bsom/machination/hardware.md

- [x] Intel NUC NUC5i5MYBE board
  * Intel® Core™ i5-5300U Processor
- [x] Front Panel Express aluminum panel
- [x] 2x 4GB DDR3L-1866 SO-DIMMs
  * https://amzn.to/31vLyne
- [x] Samsung 860 EVO SATA m.2 SSD (pick your size and manufacturer, I like Samsung)
  * https://amzn.to/2We0dTb
- [x] SATA m.2 SSD Heatsink
  * https://amzn.to/35Uymvv
- [x] Waveshare 5.5in HDMI AMOLED 1920x1080 Monitor AMOLED Capacitive Touch Screen
  * https://amzn.to/31G72O5
- [x] Sabrent miniDP to HDMI Adapter (any number of adapters would work, I just happen to have this one)
  * https://amzn.to/2W6if9E
- [x] PJRC Teensy 3.2 **WITHOUT HEADERS PRE-INSTALLED**
  * https://amzn.to/2JcVewm
- [x] 8x DuPPa i2cEncoder v2.1 with RGB encoders and right-angle headers
  * https://www.tindie.com/products/saimon/i2cencoder-v21-connect-rotary-encoder-on-i2c-bus/
- [x] 8x DuPPa Large Black Encoder Knobs (order with the above encoders)
  * https://cdn.tindiemedia.com/images/resize/uRAIfTKjbQK2f8lD7G_SOLtqw-M=/p/full-fit-in/2400x1600/i/59667/products/2018-12-07T21%3A12%3A30.715Z-Black_knob_2.jpg
- [x] Gorite USB A Dual Female Panel Mount to 1X8 Pin Internal USB Connector - 9 in.
  * https://www.gorite.com/usb-a-dual-female-panel-mount-to-1x8-pin-internal-usb-connector-9-inches-intl-2xusb-p8-9in
- [x] Gorite Intel NUC Internal Power Cable 12 Inches 4 Pin to 4 Pin
  * https://amzn.to/33Tsv80
- [x] Schmartboard 3" Female-Female jumpers with single row header
  * https://amzn.to/31Xx5ki
- [x] Nylon standoff kit
  * https://amzn.to/2BxoARU
- [x] Acrylic Display Mounting Panel 150mm x 100mm
  * Laser cut in 3mm (or 1/8") acrylic, color doesn't matter as it is hidden from view
- [x] StarTech UUSBHAUB6IN 6 inch Micro USB to USB A cable
  * https://amzn.to/31CHr8X
- [x] 18" USB Micro to USB A cable
  * Should come with the WaveShare Display
- [x] HDMI U-Turn adapter
  * Should come with the WaveShare Display
- [x] Panel-mount power adapter jack 5.5mm x 2.1mm
  * https://amzn.to/2WJQNit
- [x] Uxcell Foam Seal Tape, 5mm Wide x 1mm Thick (length doesn't matter)
  * https://amzn.to/2pPP6Ux
- [x] Heatshrink tubing kit
  * https://amzn.to/2QqiBaa
- [X] Combo Power Switch/ Power LED
  * https://www.amazon.com/uxcell-Momentary-Button-Switch-Mounting/dp/B07HFX4M6Z
- [x] Scotch Foam Mounting Tape
  * https://www.amazon.com/Scotch-Permanent-Mounting-Tape-Inches/dp/B00347A8GC
- [x] Micro SATA Cables Internal 2mm Rectangular Connector 10 Pin Female to Male 12 Inches
  * https://www.amazon.com/Internal-Rectangular-Connector-Female-Inches/dp/B01I5WJHKI
