bsom/machination/interface plate/interface_plate.pdf

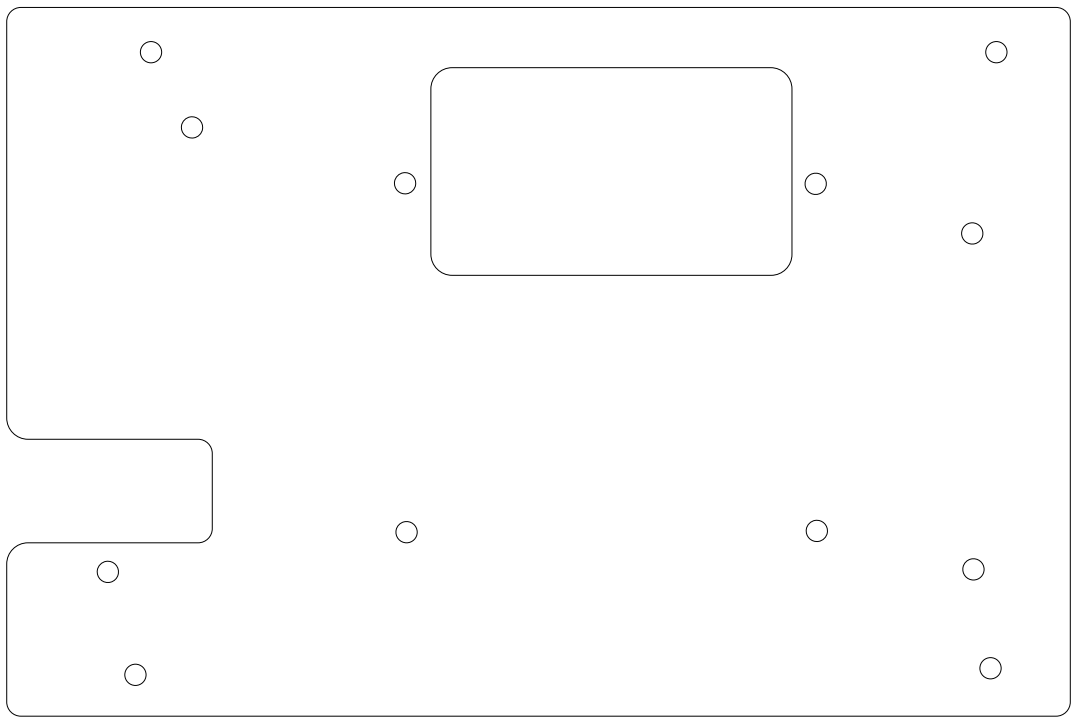
[picture p2: figure]
