bsom/machination/images/cutting_power_cable.png

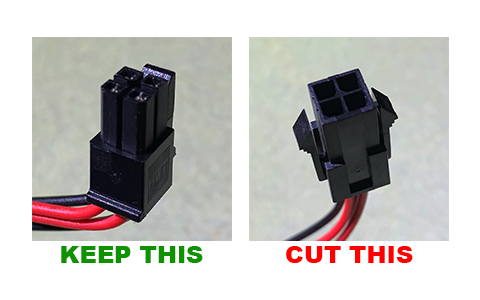
images/cutting_power_cable.png
