bsom/machination/images/encoders_4_similar.png

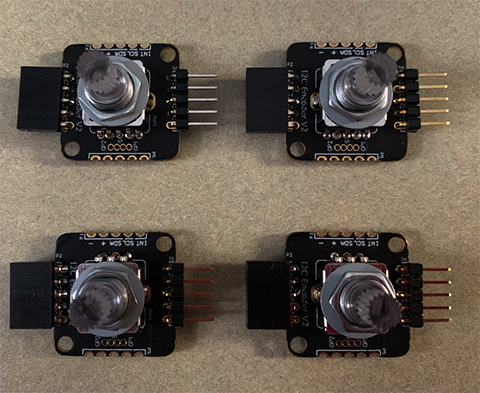
images/encoders_4_similar.png
