bsom/machination/images/encoders_back_of_ring.png

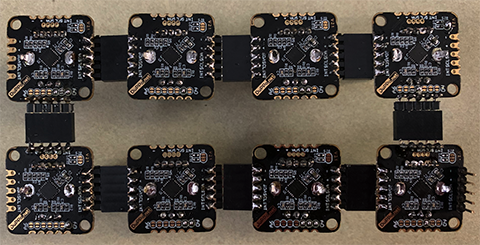
images/encoders_back_of_ring.png
