bsom/machination/images/encoders_ring.png

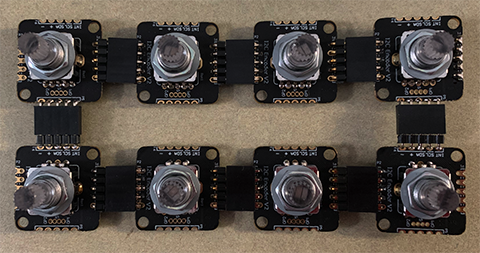
images/encoders_ring.png
