bsom/machination/images/encoders_ring_exploded.png

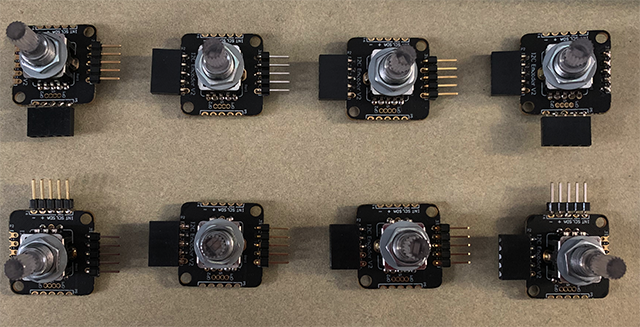
images/encoders_ring_exploded.png
