bsom/machination/images/encoders_Teensy_pins_1.png

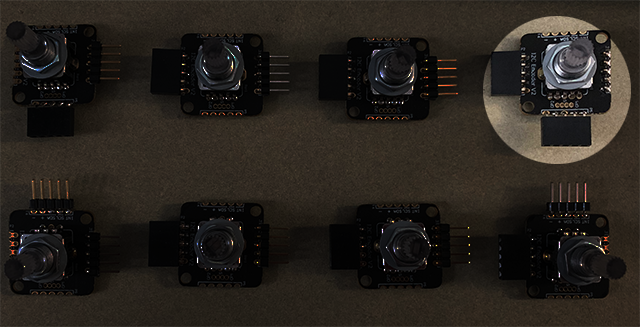
images/encoders_Teensy_pins_1.png
