bsom/machination/images/encoders_Teensy_pins_2.png

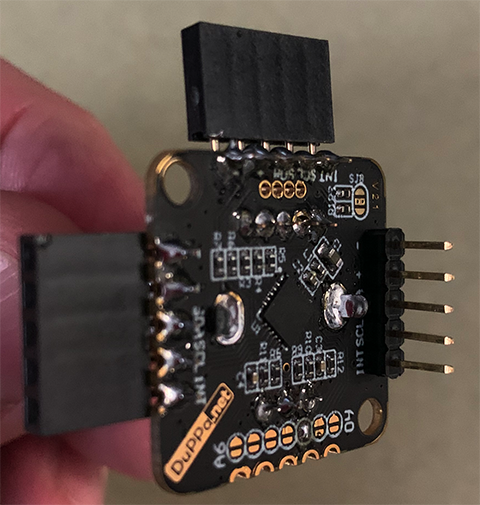
images/encoders_Teensy_pins_2.png
