bsom/machination/images/hdmi_adapter.png

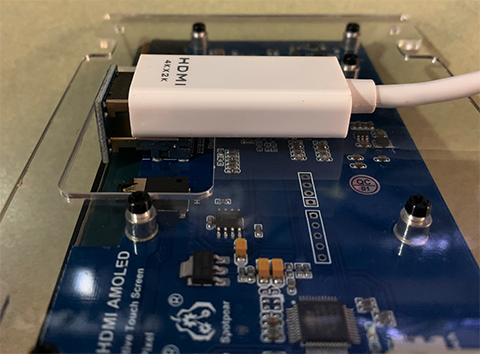
images/hdmi_adapter.png
