bsom/machination/images/hdmiuturn.png

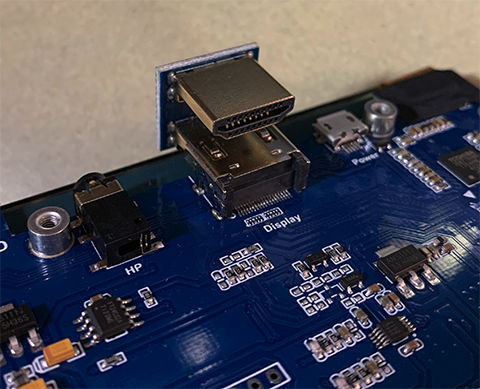
images/hdmiuturn.png
