bsom/machination/images/interface_plate.png

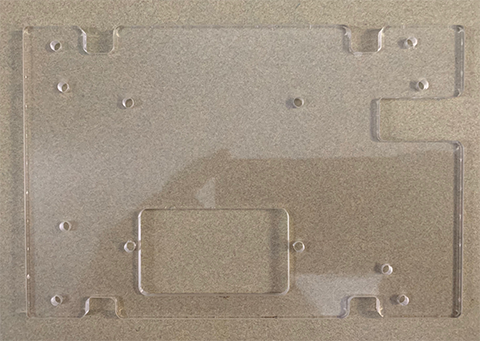
images/interface_plate.png
