bsom/machination/images/interfaceplate_screws_1.png

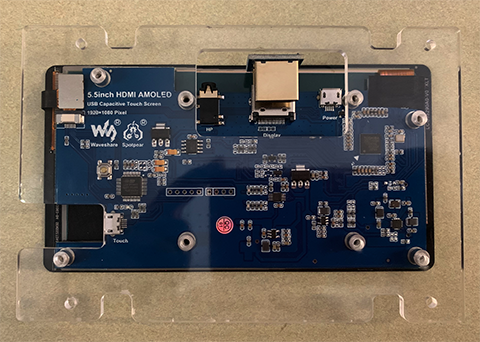
images/interfaceplate_screws_1.png
