bsom/machination/images/interfaceplate_screws_2.png

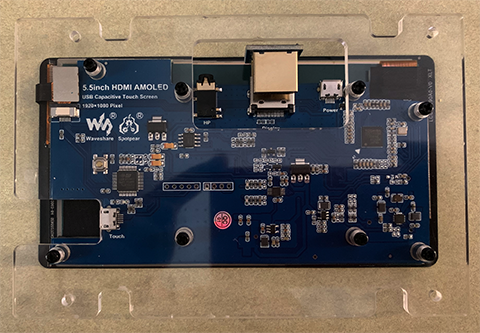
images/interfaceplate_screws_2.png
