bsom/machination/images/power_jack_both_heat_shrinks.png

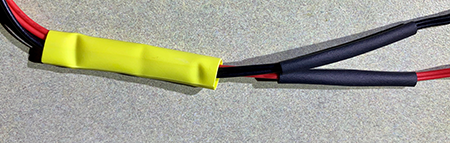
images/power_jack_both_heat_shrinks.png
