bsom/machination/images/power_jack_individual_heat_shrink.png

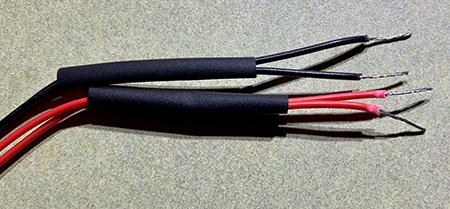
images/power_jack_individual_heat_shrink.png
