bsom/machination/images/power_jack_large_heat_shrink.png

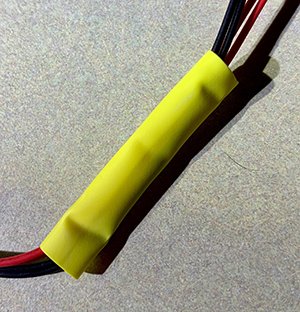
images/power_jack_large_heat_shrink.png
