bsom/machination/images/power_jack_slide_small_heat_shrink.png

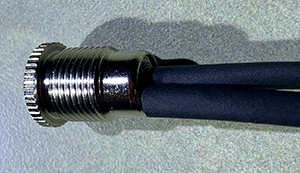
images/power_jack_slide_small_heat_shrink.png
