bsom/machination/images/power_jack_stripped_wires.png

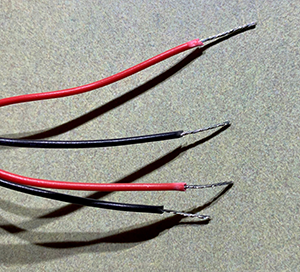
images/power_jack_stripped_wires.png
