bsom/machination/images/power_jack_tin_wire_pairs.png

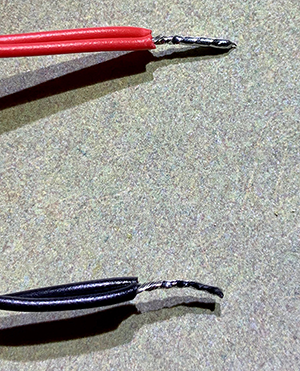
images/power_jack_tin_wire_pairs.png
