bsom/machination/images/power_jack_twist_wires.png

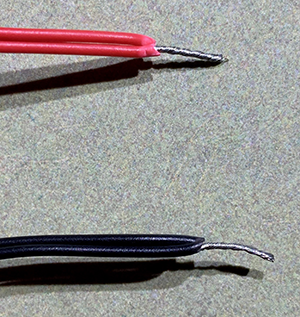
images/power_jack_twist_wires.png
