bsom/machination/images/teensy_back_with_pins.png

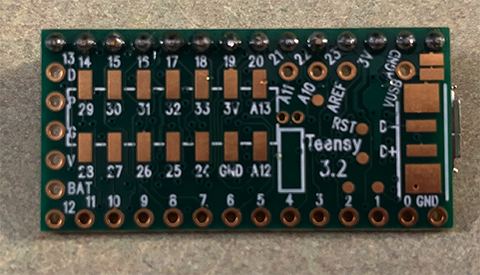
images/teensy_back_with_pins.png
