bsom/machination/images/teensy_top_with_pins.png

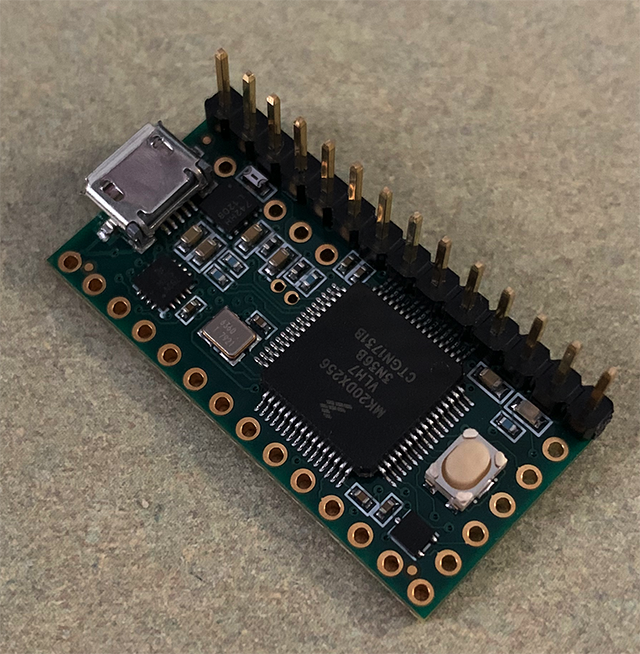
images/teensy_top_with_pins.png
