bsom/machination/images/power_jack_parts.png

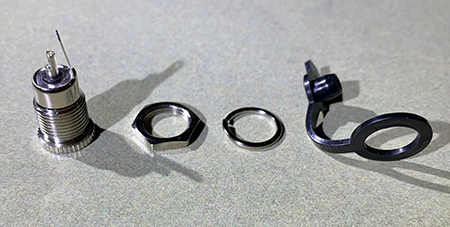
images/power_jack_parts.png
