bsom/machination/images/encoder_address_soldering_map.pdf

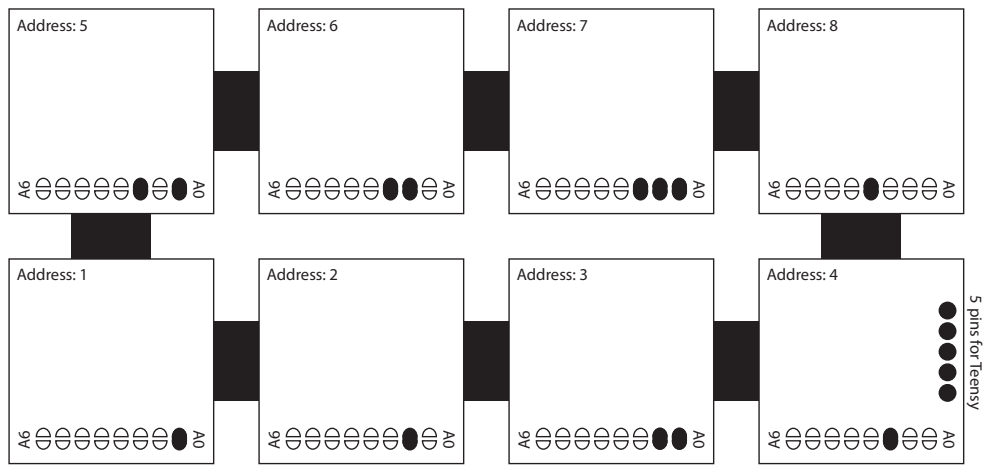
[picture p25: page 1]
Address: 1; Address: 5; Address: 2; Address: 6; Address: 3; Address: 7; Address: 4; Address: 8

5 pins for Teensy
