bsom/machination/technical docs/pwrsw_pwrled_wiring.pdf

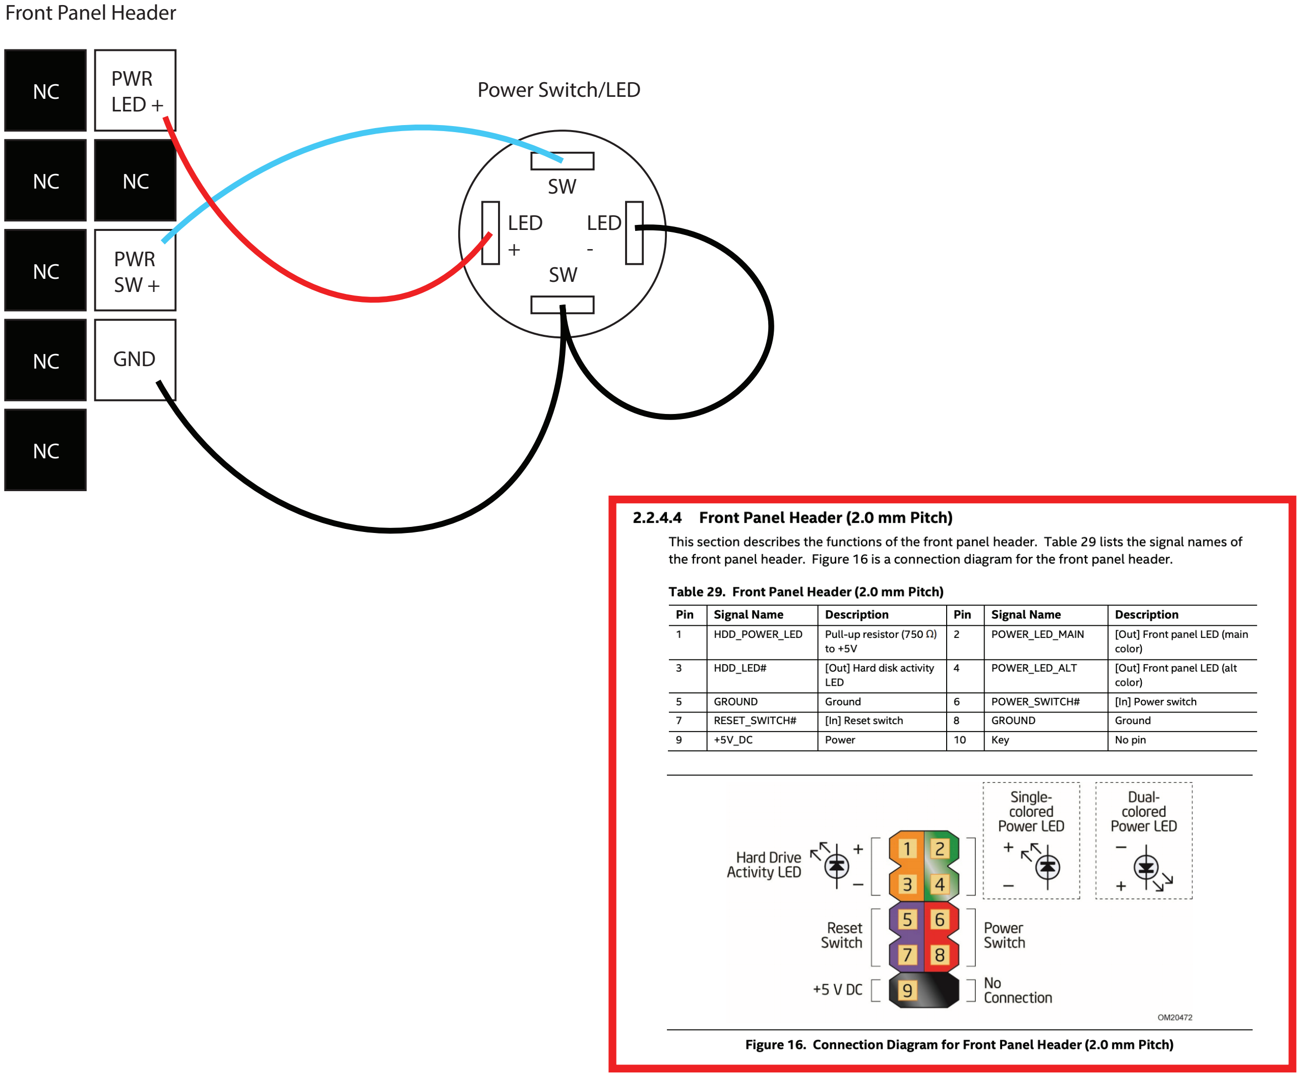
[picture p26: figure]
PWR SW +; GND; PWR LED +; LED +; LED -; Front Panel Header; Power Switch/LED
