bsom/machination/images/power_jack_both_soldered.png

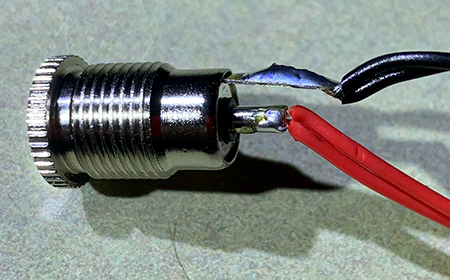
images/power_jack_both_soldered.png
