bsom/machination/images/power_jack_fill_solder_cup.png

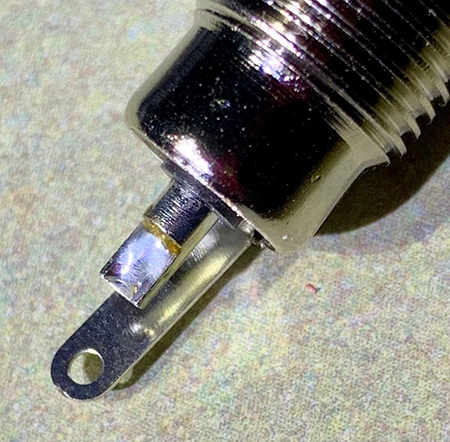
images/power_jack_fill_solder_cup.png
