bsom/machination/images/power_jack_positive_soldered.png

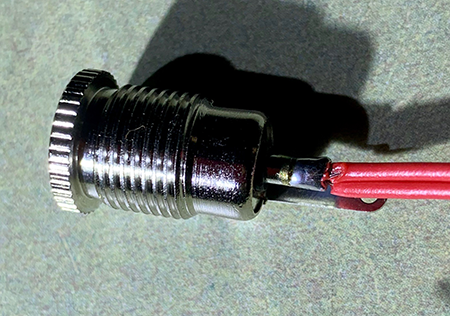
images/power_jack_positive_soldered.png
