bsom/machination/(commit log)

2020-02-12 Add files via upload
    Added power switch/LED combo. Also tilted panel mount connectors for that funky 80's future-vibe (and so they fit better.)
2020-02-17 Switched to mido, et al.
    Switched to mido in Python, switched to virtualMIDI, added support for getting clip colors from Ableton and setting knob colors accordingly.
2022-04-06 Encoder Library for Teensy
    https://github.com/Fattoresaimon/ArduinoDuPPaLib
2022-04-06 Blank Knob LED's when no clip is selected
2022-04-06 Knob LEDs Off when no clip is selected
2022-04-06 Cleaned Up Comments and Debug Serial Prints
2022-04-06 Missed Some Serial Print Debug Statements
    [machination.ino]
2022-04-06 Turn Off Knob LEDs w/No Clip Selected
2022-04-12 Changed Button Font and Layout
2022-04-19 Begin Button Stylization
2022-04-19 Keep Track Numbers White
2022-04-19 Update Color Matching.xlsx
    [Color Matching.xlsx]
2022-05-02 Organization of files
    [Color Matching.xlsx]
